etherkit/CC1/documentation/CC1-PCB-AF.png

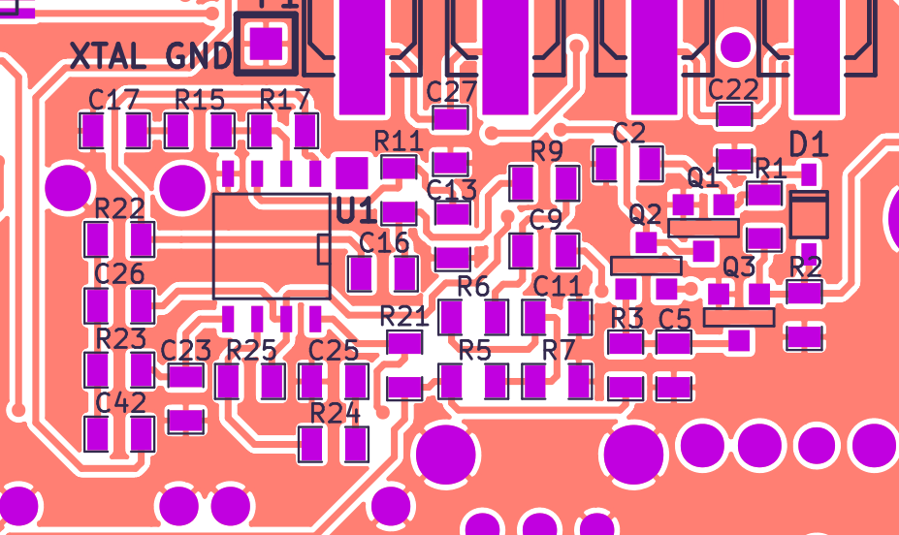
documentation/CC1-PCB-AF.png
