etherkit/CC1/pcb/CC1-PCB-Back.png

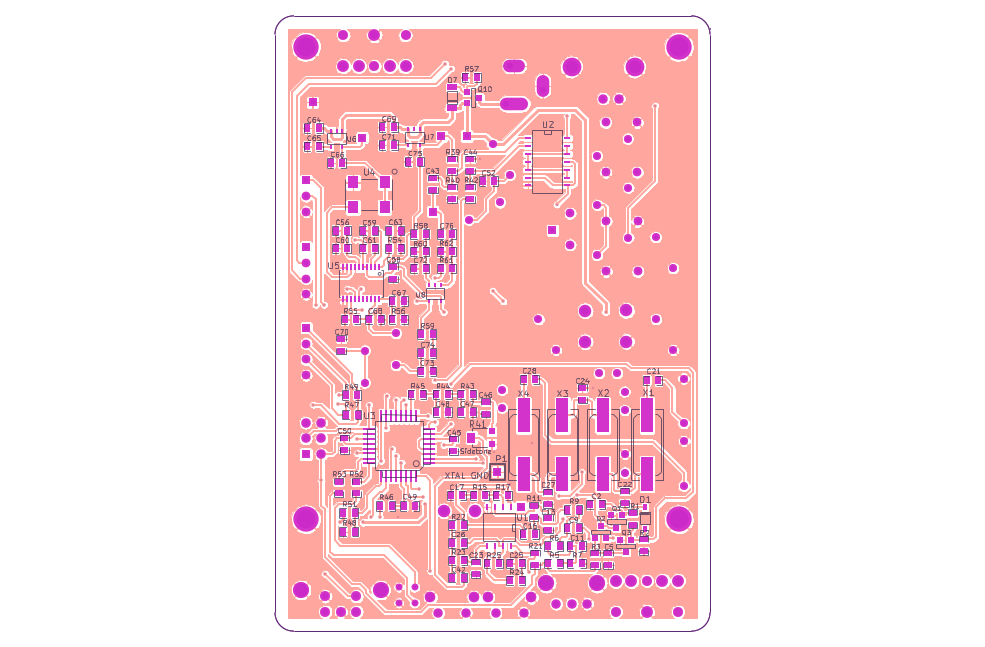
pcb/CC1-PCB-Back.png
