etherkit/CC1/pcb/CC1_PCB_Front.png

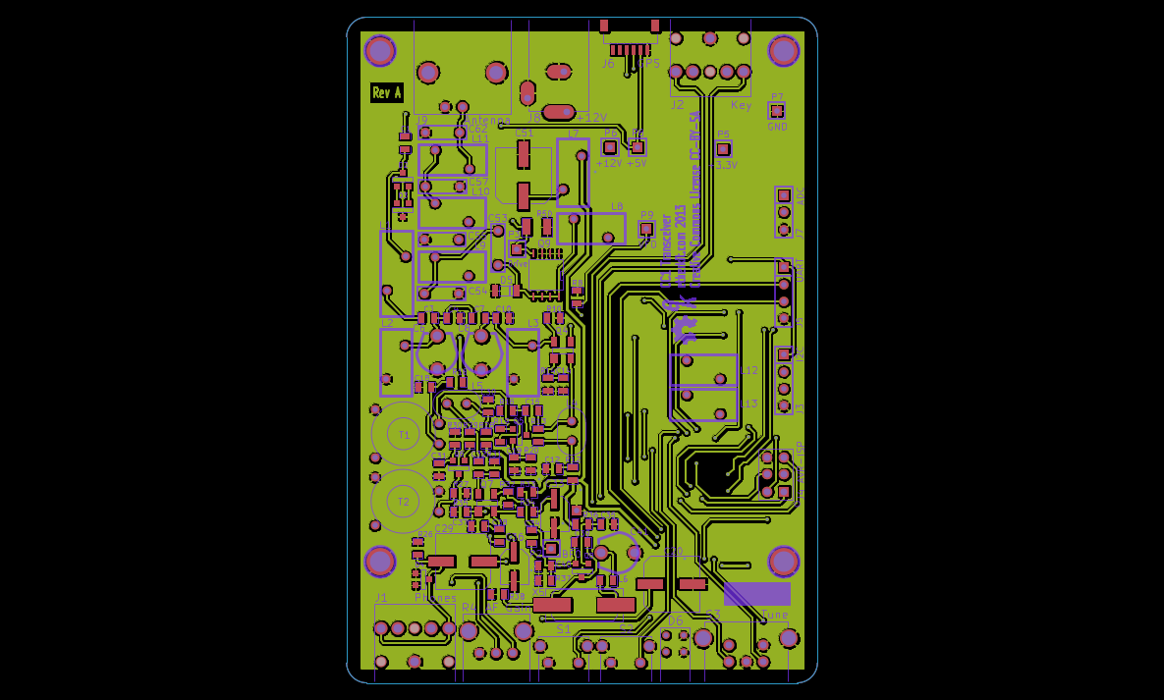
pcb/CC1_PCB_Front.png
