etherkit/CC1/documentation/CC1 Schematics.pdf

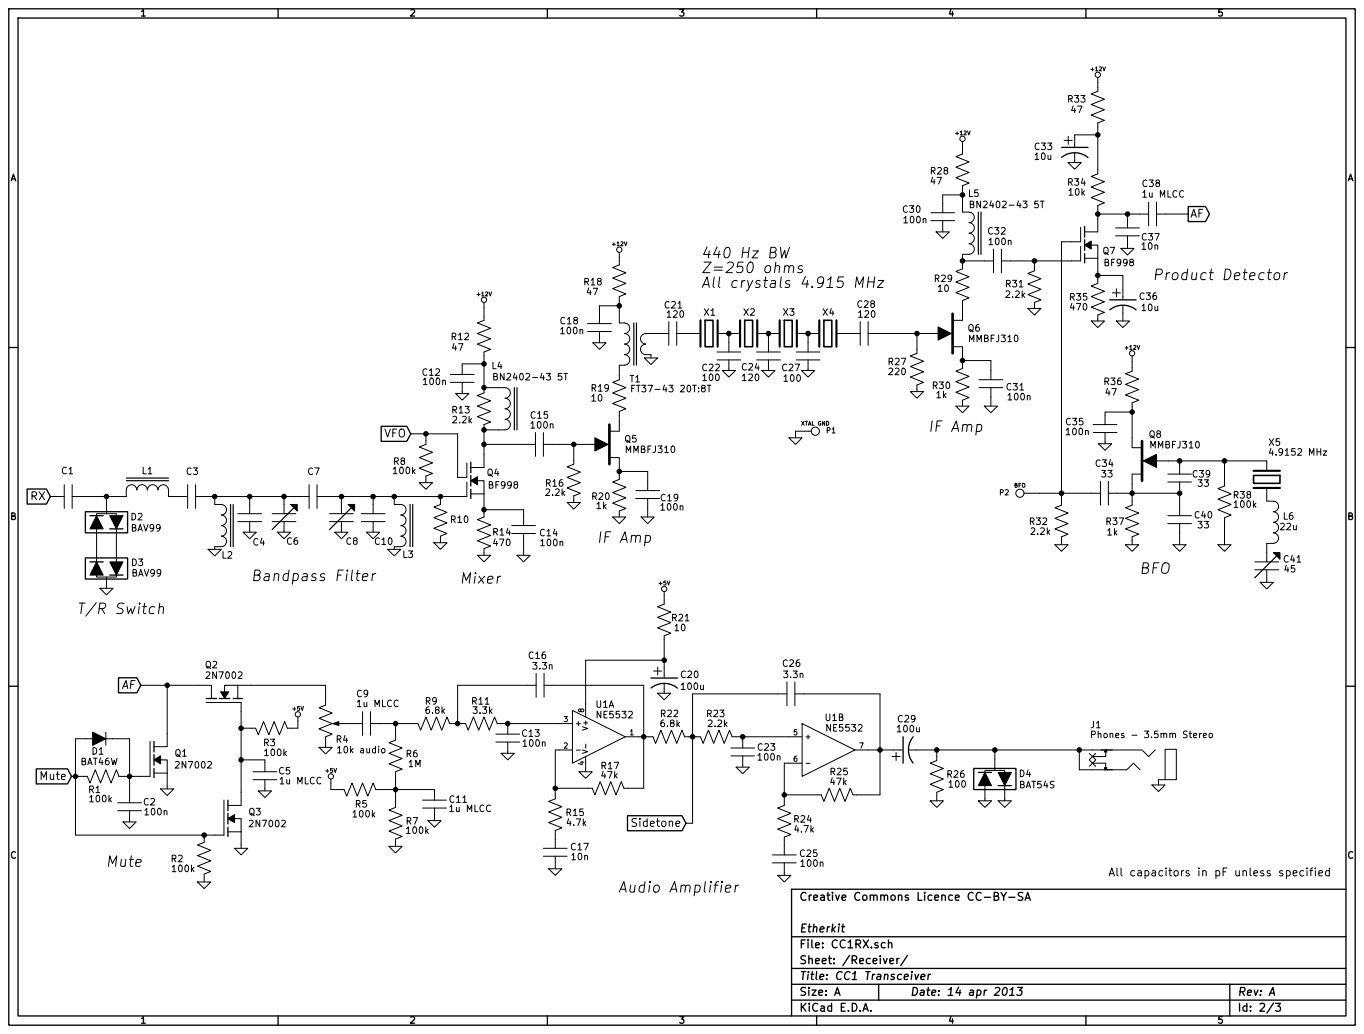
[picture p4: page 1]

Sheet: /Receiver/ Etherkit Creative Commons Licence CC-BY-SA

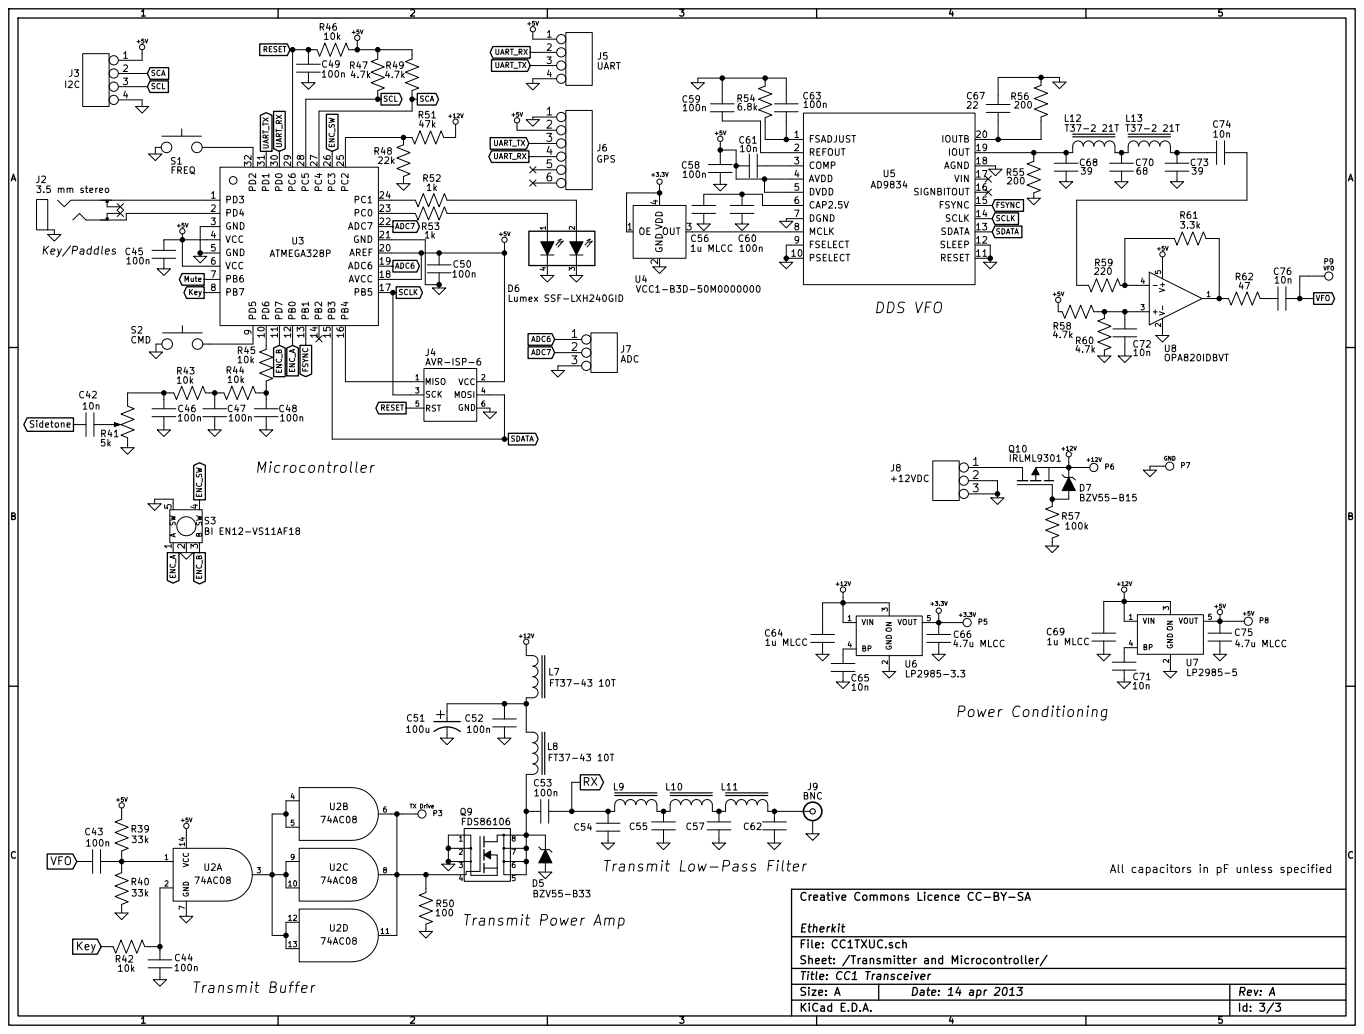
[picture p5: page 2]

3.5 mm stereo Key/Paddles

VCC GND MISO MOSI RST

J9 BNC RX Transmit Power Amp

Transmit Low-Pass Filter

Sheet: /Transmitter and Microcontroller/ Etherkit Creative Commons Licence CC-BY-SA
