etherkit/CC1/pcb/CC1.pdf

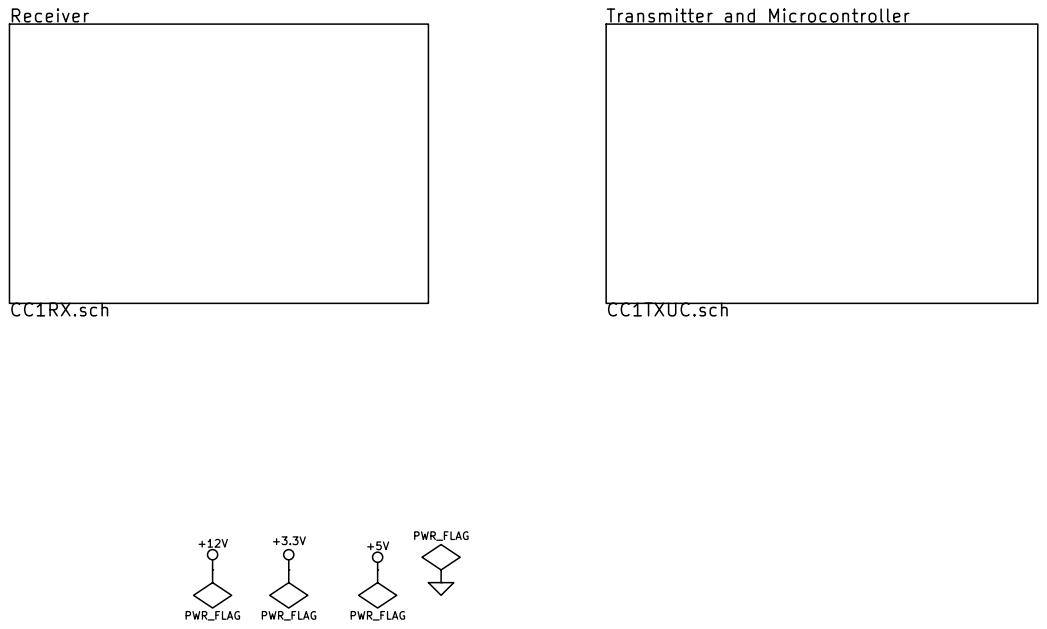
[picture p6: page 1]

Sheet: / Etherkit Creative Commons Licence CC-BY-SA


Sheet: /Receiver/ Etherkit Creative Commons Licence CC-BY-SA


3.5 mm stereo Key/Paddles

VCC GND MISO MOSI RST

J9 BNC RX Transmit Power Amp

Transmit Low-Pass Filter

Sheet: /Transmitter and Microcontroller/ Etherkit Creative Commons Licence CC-BY-SA
