etherkit/CC1/pcb/CC1.kicad_pcb

## KiCad design pcb/CC1.kicad_pcb (2013-01-31)

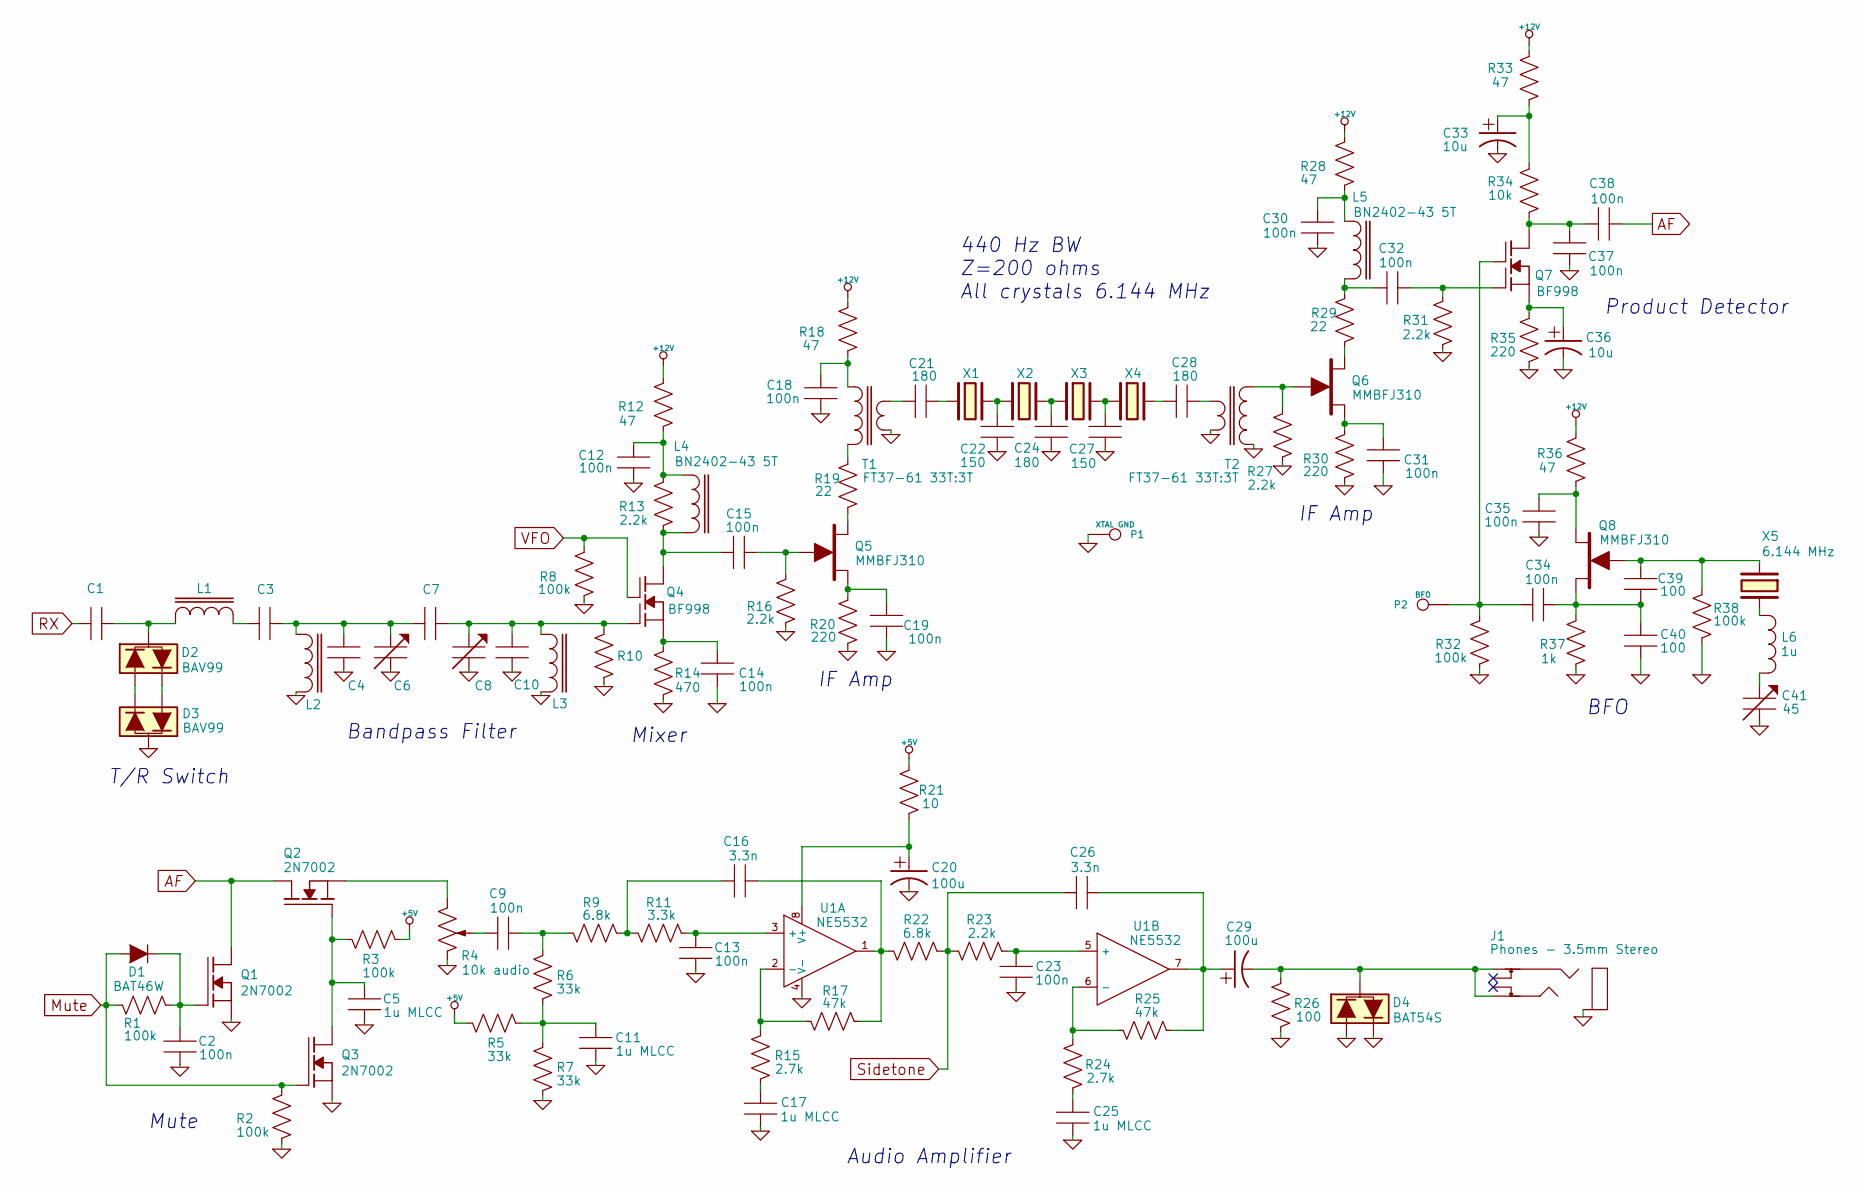
[picture p7: schematic CC1RX.sch, CC1 Transceiver]

Parts:
C1, C3, C4, C7, C10: C
C2, C9, C12, C13, C14, C15, C18, C19, C23, C30, C31, C32, C34, C35, C37, C38: 100n
C5, C11, C17, C25: 1u MLCC
C6, C8: CTRIM
C16, C26: 3.3n
C20, C29: 100u
C21, C24, C28: 180
C22, C27: 150
C33, C36: 10u
C39, C40: 100
C41: 45
D1: BAT46W
D2, D3: BAV99
D4: BAT54S
J1: Phones - 3.5mm Stereo
L1, L2, L3: L-IRONCORE
L4, L5: BN2402-43 5T
L6: 1u
P1: XTAL GND
P2: BFO
Q1, Q2, Q3: 2N7002
Q4, Q7: BF998
Q5, Q6, Q8: MMBFJ310
R1, R2, R3, R8, R32, R38: 100k
R4: 10k audio
R5, R6, R7: 33k
R9, R22: 6.8k
R10: R
R11: 3.3k
R12, R18, R28, R33, R36: 47
R13, R16, R23, R27, R31: 2.2k
R14: 470
R15, R24: 2.7k
R17, R25: 47k
R19, R29: 22
R20, R30, R35: 220
R21: 10
R26: 100
R34: 10k
R37: 1k
T1, T2: FT37-61 33T:3T
U1: NE5532
X1, X2, X3, X4, X5: 6.144 MHz

Connections:
+5V: R3.2, R5.1, R21.1; also elsewhere on the board
+12V: R12.1, R18.1, R28.1, R33.1, R36.1; also elsewhere on the board
AF: C38.1, Q1.3 (D), Q2.3 (D)
GND: C2.2, C4.1, C5.2, C6.2, C8.2, C10.1, C11.2, C12.2, C13.2, C14.1, C17.2, C18.2, C19.1, C20.2, C22.2, C23.2, C24.2, C25.2, C27.2, C30.2, C31.1, C33.2, C35.2, C36.2, C37.2, C40.1, C41.2, D3.3, D4.1, D4.2, J1.1, L2.2, L3.2, P1.1, Q1.1 (S), Q3.1 (S), R2.2, R4.3, R7.2, R8.2, R10.2, R14.2, R16.2, R20.2, R26.2, R27.2, R30.2, R31.2, R32.2, R35.2, R37.2, R38.2, T1.4, T2.2, T2.4, U1.4 (V-); also elsewhere on the board
Mute: D1.1 (A), Q3.2 (G), R1.1, R2.1; also elsewhere on the board
unnamed: C18.1, R18.2, T1.1
unnamed: R19.1, T1.2
unnamed: C15.1, Q5.2 (G), R16.1
unnamed: Q5.3 (D), R19.2
unnamed: C21.2, T1.3
unnamed: C21.1, X1.1
unnamed: C28.2, X4.2
unnamed: C28.1, T2.3
unnamed: C12.1, L4.1, R12.2, R13.1
unnamed: C15.2, L4.2, Q4.2 (D), R13.2
unnamed: C24.1, X2.2, X3.1
unnamed: C19.2, Q5.1 (S), R20.1
unnamed: C30.1, L5.1, R28.2
unnamed: Q6.3 (D), R29.2
unnamed: C33.1, R33.2, R34.1
unnamed: C37.1, C38.2, Q7.2 (D), R34.2
unnamed: C27.1, X3.2, X4.1
unnamed: C22.1, X1.2, X2.1
unnamed: C31.2, Q6.1 (S), R30.1
unnamed: Q6.2 (G), R27.1, T2.1
unnamed: C3.1, L1.2
unnamed: R24.1, R25.1, U1.6 (-)
unnamed: C23.1, R23.2, U1.5 (+)
unnamed: C25.1, R24.2
unnamed: C14.2, Q4.1 (S), R14.1
unnamed: C1.2, D2.3, L1.1
unnamed: D2.1, D3.2
unnamed: D2.2, D3.1
unnamed: C7.2, C8.1, C10.2, L3.1, Q4.4 (G1), R10.1
unnamed: C3.2, C4.2, C6.1, C7.1, L2.1
unnamed: C16.2, R9.2, R11.1
unnamed: C20.1, R21.2, U1.8 (V+)
unnamed: C26.1, C29.1, R25.2, U1.7
unnamed: C13.1, R11.2, U1.3 (+)
unnamed: C16.1, R17.2, R22.1, U1.1
unnamed: C17.1, R15.2
unnamed: R15.1, R17.1, U1.2 (-)
unnamed: C29.2, D4.3, J1.2, J1.5, R26.1
unnamed: C9.1, R6.1, R9.1
unnamed: C39.2, Q8.2 (G), R38.1, X5.1
unnamed: C34.1, C39.1, C40.2, Q8.1 (S), R37.1
unnamed: C35.1, Q8.3 (D), R36.2
unnamed: C32.1, Q7.4 (G1), R31.1
unnamed: C36.1, Q7.1 (S), R35.1
unnamed: C32.2, L5.2, R29.1
unnamed: C34.2, P2.1, Q7.3 (G2), R32.1
unnamed: C41.1, L6.2
unnamed: L6.1, X5.2
unnamed: C5.1, Q2.2 (G), Q3.3 (D), R3.1
unnamed: Q2.1 (S), R4.1
unnamed: C9.2, R4.2
unnamed: C11.1, R5.2, R6.2, R7.1
unnamed: C2.1, D1.2 (K), Q1.2 (G), R1.2
RX: C1.1; also elsewhere on the board
Sidetone: C26.2, R22.2, R23.1; also elsewhere on the board
VFO: Q4.3 (G2), R8.1; also elsewhere on the board

Notes on the sheet:
BFO
440 Hz BW Z=200 ohms All crystals 6.144 MHz
Mute
Product Detector
IF Amp
Mixer
Bandpass Filter
T/R Switch
Audio Amplifier

Schematic: CC1TXUC.sch, CC1 Transceiver

Parts:
C42, C43, C44, C45, C46, C47, C48, C49, C50, C52, C53, C54, C55, C57, C58, C59, C60, C62, C63: 100n
C51: 100u
C56, C64, C69: 1u MLCC
C61, C65, C71, C72, C74, C76: 10n
C66, C75: 4.7u MLCC
C67: 22
C68, C73: 39
C70: 68
D5, D7: BZV55-B15
D6: Lumex SSF-LXH240GID
J2: 3.5 mm stereo
J3: I2C
J4: AVR-ISP-6
J5: UART
J6: GPS
J7: ADC
J8: +12VDC
J9: BNC
L7, L8: FT37-43 10T
L9, L10, L11: L-IRONCORE
L12, L13: T37-2 21T
P3: TX Drive
P5: +3.3V
P6: +12V
P7: GND
P8: +5V
P9: VFO
Q9: FDS86106
Q10: IRLML9301
R39, R40, R43, R44, R45: 33k
R41: 5k
R42, R46: 10k
R47, R49, R58, R60: 4.7k
R48: 22k
R50: 100
R51: 47k
R52, R53: 1k
R54: 6.8k
R55, R56: 200
R57: 100k
R59: 220
R61: 2.2k
R62: 51
S1: FREQ
S2: CMD
S3: BI EN12-VS11AF18
U2: 74AC08
U3: ATMEGA328P; MODULE
U4: VCC1-B3D-50M0000000
U5: AD9834
U6: LP2985-3.3
U7: LP2985-5
U8: OPA820IDBVT

Connections:
+3.3V: C66.2, P5.1, U4.1 (OE), U4.4 (VDD), U6.5 (VOUT)
+5V: C45.2, C50.2, C58.2, C61.1, C75.2, J3.1, J4.2, J5.1, J6.2, P8.1, R39.1, R46.1, R47.1, R49.1, R58.2, U2.14 (VCC), U3.4, U3.6, U3.18, U3.20, U5.4 (AVDD), U5.5 (DVDD), U7.5 (VOUT), U8.5 (V+); also elsewhere on the board
+12V: C64.2, C69.2, D7.2 (K), L7.1, P6.1, Q10.1 (S), R51.1, U6.1 (VIN), U6.3 (ON), U7.1 (VIN), U7.3 (ON); also elsewhere on the board
ADC6: J7.1, U3.19
ADC7: J7.2 (PM), U3.22
ENC_A: S3.1 (A), U3.12
ENC_B: S3.3 (B), U3.11
ENC_SW: S3.4 (SW), U3.26
FSYNC: U3.13, U5.15 (FSYNC)
GND: C44.1, C45.1, C46.1, C47.1, C48.1, C49.1, C50.1, C51.2, C52.1, C54.1, C55.1, C56.1, C57.1, C58.1, C59.2, C60.1, C62.1, C63.2, C64.1, C65.1, C66.1, C67.2, C68.1, C69.1, C70.1, C71.1, C72.1, C73.1, C75.1, D5.1 (A), D6.3 (K), D6.4 (K), J2.1, J3.4, J4.6, J5.4, J6.1, J7.3, J8.2 (PM), J8.3, J9.2 (Ext), P7.1, Q9.1 (S), Q9.2 (S), Q9.3 (S), R40.2, R41.3, R48.2, R50.2, R54.1, R55.2, R56.1, R57.2, R60.2, R62.2, S1.1, S2.1, S3.2, S3.5 (SW), U2.7 (GND), U3.3, U3.5, U3.21, U4.2 (GND), U5.7 (DGND), U5.9 (FSELECT), U5.10 (PSELECT), U5.11 (RESET), U5.12 (SLEEP), U5.18 (AGND), U6.2 (GND), U7.2 (GND), U8.2 (V-); also elsewhere on the board
Key: R42.2, U3.8
Mute: U3.7; also elsewhere on the board
unnamed: C61.2, U5.3 (COMP)
unnamed: C63.1, R54.2, U5.1 (FSADJUST)
unnamed: C56.2, C60.2, U5.6 (CAP2.5V)
unnamed: C59.1, U5.2 (REFOUT)
unnamed: C67.1, R56.2, U5.20 (IOUTB)
unnamed: C68.2, L12.1, R55.1, U5.19 (IOUT)
unnamed: C70.2, L12.2, L13.1
unnamed: C73.2, C74.1, L13.2
unnamed: U4.3 (OUT), U5.8 (MCLK)
unnamed: C71.2, U7.4 (BP)
unnamed: C65.2, U6.4 (BP)
unnamed: D7.1 (A), Q10.2 (G), R57.1
unnamed: C44.2, R42.1, U2.2
unnamed: C72.2, R58.1, R60.1, U8.3 (+)
unnamed: R59.1, R61.2, U8.4 (-)
unnamed: C74.2, R59.2
unnamed: J8.1, Q10.3 (D)
unnamed: C76.1, R61.1, R62.1, U8.1
unnamed: C51.1, C52.2, L7.2, L8.1
unnamed: C53.1, D5.2 (K), L8.2, Q9.5 (D), Q9.6 (D), Q9.7 (D), Q9.8 (D)
unnamed: C62.2, J9.1 (In), L11.2
unnamed: C57.2, L10.2, L11.1
unnamed: C55.2, L9.2, L10.1
unnamed: J2.5, U3.1
unnamed: J2.2, U3.2
unnamed: C43.2, R39.2, R40.1, U2.1
unnamed: U2.3, U2.4, U2.5, U2.9, U2.10, U2.12, U2.13
unnamed: P3.1, Q9.4 (G), R50.1, U2.6, U2.8, U2.11
unnamed: D6.2 (A), R52.1
unnamed: R52.2, U3.24
unnamed: D6.1 (A), R53.1
unnamed: R53.2, U3.23
unnamed: R48.1, R51.2, U3.25
unnamed: S2.2, U3.9
unnamed: S1.2, U3.32
unnamed: R45.1, U3.10
unnamed: C48.2, R44.1, R45.2
unnamed: C47.2, R43.1, R44.2
unnamed: C46.2, R41.1, R43.2
unnamed: J4.1, U3.16
unnamed: C42.2, R41.2
RESET: C49.2, J4.5, R46.2, U3.29
RX: C53.2, C54.2, L9.1; also elsewhere on the board
SCA: J3.2, R49.2, U3.27
SCL: J3.3, R47.2, U3.28
SCLK: J4.3, U3.17, U5.14 (SCLK)
SDATA: J4.4, U3.15, U5.13 (SDATA)
Sidetone: C42.1; also elsewhere on the board
UART_RX: J5.2, J6.4, U3.30
UART_TX: J5.3, J6.3, U3.31
VFO: C43.1, C76.2, P9.1; also elsewhere on the board

Notes on the sheet:
Transmit Buffer
Transmit Power Amp
Transmit Low-Pass Filter
Key/Paddles
Microcontroller
DDS VFO
Power Conditioning

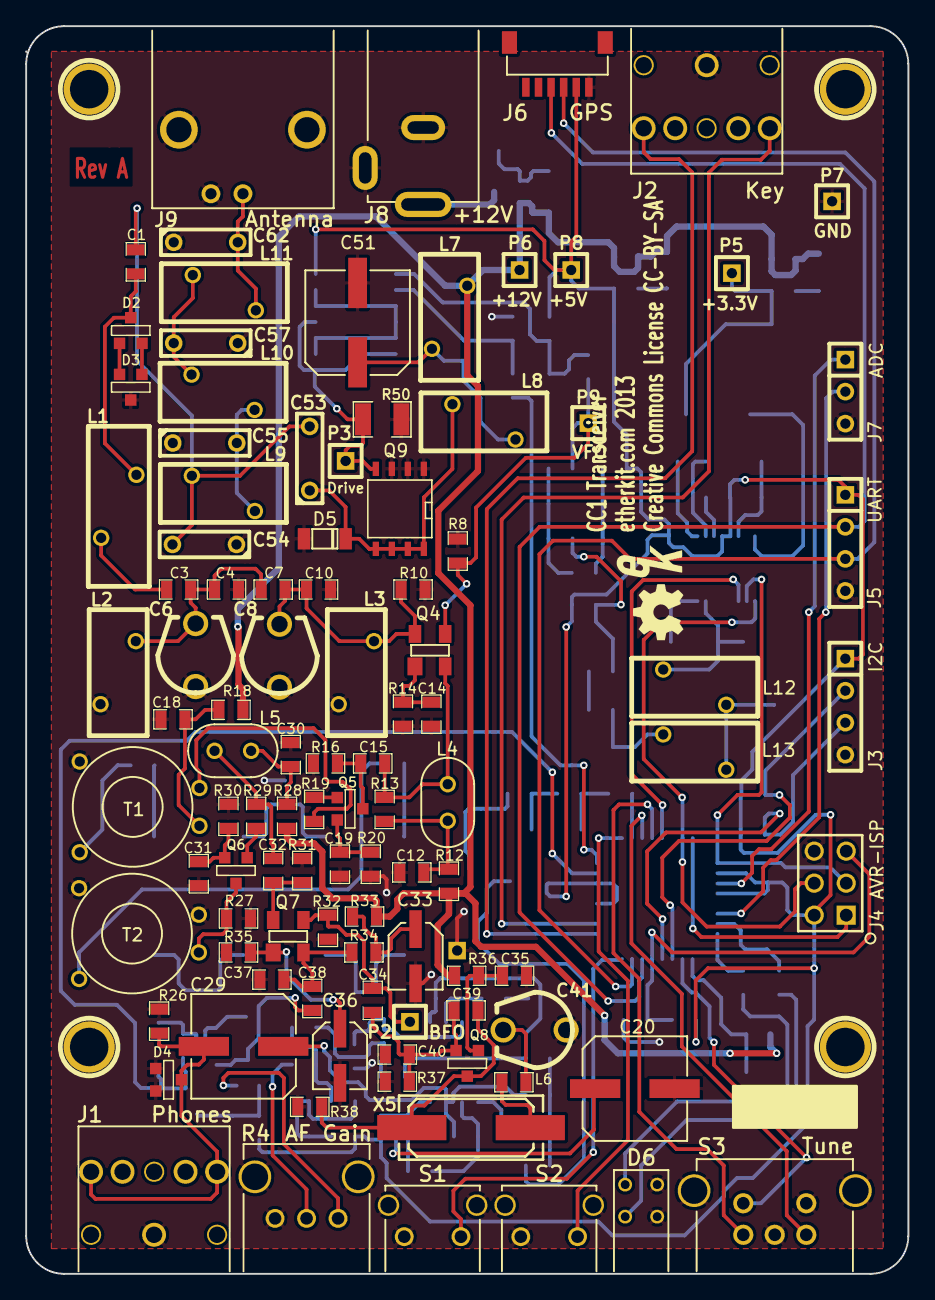
[picture p8: board CC1.kicad_pcb from above]

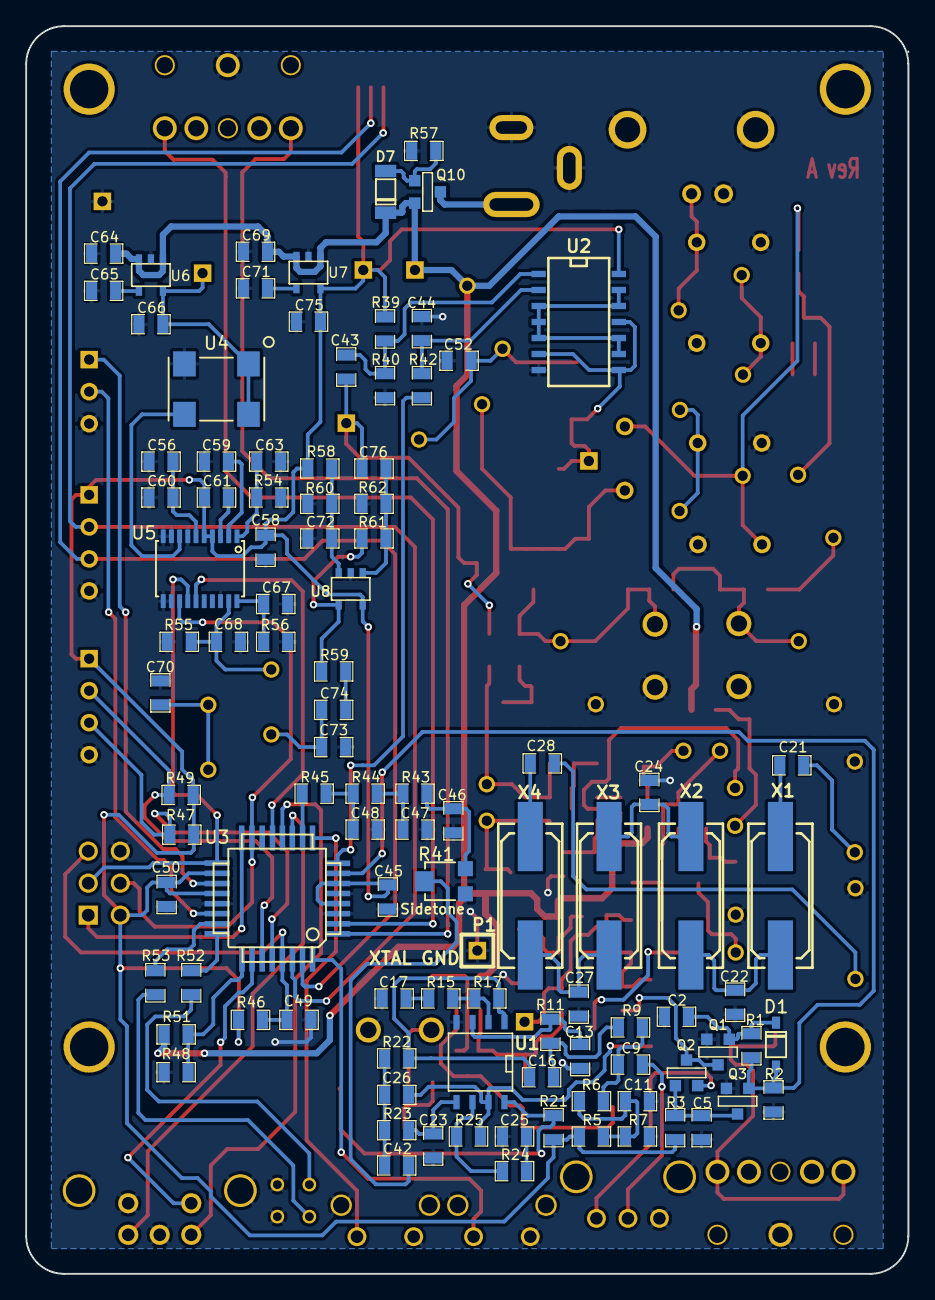
[picture p9: board CC1.kicad_pcb from below]

Board: 2 copper layers, 70.0 x 99.0 mm, 208 parts (101 on the bottom side), 117 nets.

Other parts of the board:
1PIN, 1PIN#2, 1PIN#3, 1PIN#4: P***; MOUNTINGHOLE
Ref**: Val**; EtherkitLogoSmall

Their connections:
GND: 1PIN.1, 1PIN#2.1, 1PIN#3.1, 1PIN#4.1; also elsewhere on the board
