etherkit/CC1/firmware/sinewave.h

/*
 * sinewave.h
 *
 *  Created on: Dec 14, 2010
 *      Author: jason
 */

#ifndef SINEWAVE_H_
#define SINEWAVE_H_

#include <stdint.h>
#include <avr/pgmspace.h>

#define PWM_ARRAY_SIZE			256

const uint8_t sinewave[] PROGMEM =
	{
	0x80,0x83,0x86,0x89,0x8c,0x8f,0x92,0x95,0x98,0x9c,0x9f,0xa2,0xa5,0xa8,0xab,0xae,
	0xb0,0xb3,0xb6,0xb9,0xbc,0xbf,0xc1,0xc4,0xc7,0xc9,0xcc,0xce,0xd1,0xd3,0xd5,0xd8,
	0xda,0xdc,0xde,0xe0,0xe2,0xe4,0xe6,0xe8,0xea,0xec,0xed,0xef,0xf0,0xf2,0xf3,0xf5,
	0xf6,0xf7,0xf8,0xf9,0xfa,0xfb,0xfc,0xfc,0xfd,0xfe,0xfe,0xff,0xff,0xff,0xff,0xff,
	0xff,0xff,0xff,0xff,0xff,0xff,0xfe,0xfe,0xfd,0xfc,0xfc,0xfb,0xfa,0xf9,0xf8,0xf7,
	0xf6,0xf5,0xf3,0xf2,0xf0,0xef,0xed,0xec,0xea,0xe8,0xe6,0xe4,0xe2,0xe0,0xde,0xdc,
	0xda,0xd8,0xd5,0xd3,0xd1,0xce,0xcc,0xc9,0xc7,0xc4,0xc1,0xbf,0xbc,0xb9,0xb6,0xb3,
	0xb0,0xae,0xab,0xa8,0xa5,0xa2,0x9f,0x9c,0x98,0x95,0x92,0x8f,0x8c,0x89,0x86,0x83,
	0x80,0x7c,0x79,0x76,0x73,0x70,0x6d,0x6a,0x67,0x63,0x60,0x5d,0x5a,0x57,0x54,0x51,
	0x4f,0x4c,0x49,0x46,0x43,0x40,0x3e,0x3b,0x38,0x36,0x33,0x31,0x2e,0x2c,0x2a,0x27,
	0x25,0x23,0x21,0x1f,0x1d,0x1b,0x19,0x17,0x15,0x13,0x12,0x10,0x0f,0x0d,0x0c,0x0a,
	0x09,0x08,0x07,0x06,0x05,0x04,0x03,0x03,0x02,0x01,0x01,0x00,0x00,0x00,0x00,0x00,
	0x00,0x00,0x00,0x00,0x00,0x00,0x01,0x01,0x02,0x03,0x03,0x04,0x05,0x06,0x07,0x08,
	0x09,0x0a,0x0c,0x0d,0x0f,0x10,0x12,0x13,0x15,0x17,0x19,0x1b,0x1d,0x1f,0x21,0x23,
	0x25,0x27,0x2a,0x2c,0x2e,0x31,0x33,0x36,0x38,0x3b,0x3e,0x40,0x43,0x46,0x49,0x4c,
	0x4f,0x51,0x54,0x57,0x5a,0x5d,0x60,0x63,0x67,0x6a,0x6d,0x70,0x73,0x76,0x79,0x7c
	};

/*
const uint8_t sinewave[] PROGMEM =
	{
	127,130,133,136,139,143,146,149,152,155,158,161,164,167,170,173,176,178,181,184,187,190,192,195,198,200,203,205,208,210,212,215,217,219,221,223,225,227,229,231,233,234,236,238,239,240,
	242,243,244,245,247,248,249,249,250,251,252,252,253,253,253,254,254,254,254,254,254,254,253,253,253,252,252,251,250,249,249,248,247,245,244,243,242,240,239,238,236,234,233,231,229,227,225,223,
	221,219,217,215,212,210,208,205,203,200,198,195,192,190,187,184,181,178,176,173,170,167,164,161,158,155,152,149,146,143,139,136,133,130,127,124,121,118,115,111,108,105,102,99,96,93,90,87,84,81,78,
	76,73,70,67,64,62,59,56,54,51,49,46,44,42,39,37,35,33,31,29,27,25,23,21,20,18,16,15,14,12,11,10,9,7,6,5,5,4,3,2,2,1,1,1,0,0,0,0,0,0,0,1,1,1,2,2,3,4,5,5,6,7,9,10,11,12,14,15,16,18,20,21,23,25,27,29,31,
	33,35,37,39,42,44,46,49,51,54,56,59,62,64,67,70,73,76,78,81,84,87,90,93,96,99,102,105,108,111,115,118,121,124

	};
	*/
/*
const uint8_t sinewave[] PROGMEM =
	{
	0x80,0x8c,0x98,0xa5,0xb0,0xbc,0xc7,0xd1,
	0xda,0xe2,0xea,0xf0,0xf6,0xfa,0xfd,0xff,
	0xff,0xff,0xfd,0xfa,0xf6,0xf0,0xea,0xe2,
	0xda,0xd1,0xc7,0xbc,0xb0,0xa5,0x98,0x8c,
	0x80,0x73,0x67,0x5a,0x4f,0x43,0x38,0x2e,
	0x25,0x1d,0x15,0x0f,0x09,0x05,0x02,0x00,
	0x00,0x00,0x02,0x05,0x09,0x0f,0x15,0x1d,
	0x25,0x2e,0x38,0x43,0x4f,0x5a,0x67,0x73
	};
	*/

/*
const uint8_t sinewave[] PROGMEM =
	{
	0x00,
	0x25,
	0x80,
	0xda,
	0xff,
	0xda,
	0x80,
	0x25
	};
	*/

/*
const uint8_t sinewave[] PROGMEM =
	{
	0x00,0x09,
	0x25,0x4f,
	0x80,0xb0,
	0xda,0xf6,
	0xff,0xf6,
	0xda,0xb0,
	0x80,0x4f,
	0x25,0x09
	};
*/

/*
const uint8_t sinewave[] PROGMEM =
	{
	0x80,0x98,0xb0,0xc7,
	0xda,0xea,0xf6,0xfd,
	0xff,0xfd,0xf6,0xea,
	0xda,0xc7,0xb0,0x98,
	0x80,0x67,0x4f,0x38,
	0x25,0x15,0x09,0x02,
	0x00,0x02,0x09,0x15,
	0x25,0x38,0x4f,0x67
	};
	*/

#endif /* SINEWAVE_H_ */
