etherkit/CC1/(commit log)

2013-01-31 First commit, conversion to CC1
    [CC1-B_Cu.gbl, CC1-B_Mask.gbs, CC1-B_SilkS.gbo, CC1-Edge_Cuts.gbr, CC1-F_Cu.gtl, CC1-F_Mask.gts, CC1-F_SilkS.gto, CC1-NPTH.drl]
2013-01-31 Update schematics for beta
    [CC1.sch, CC1RX.sch, CC1TXUC.sch]
2013-02-24 Beta test 1
    [CC1.sch, CC1RX.sch, CC1TXUC.sch]
2013-02-25 Minor correction for Beta 1
    [CC1.sch, CC1RX.sch, CC1TXUC.sch]
2013-02-25 A few more changes on Beta 1
    [CC1.sch, CC1RX.sch, CC1TXUC.sch]
2013-03-20 Minor typo correction on BOM
    [main.c]
2013-04-07 Firmware fix for RX osc hash
    [main.c]
2013-04-14 Change to T1 and L5 in schematics/BOM
    [CC1.sch, CC1RX.sch, CC1TXUC.sch]
