etherkit/CC1/(notices)

Notices in the files:
pcb/CC1.kicad_pcb:
Creative Commons License CC-BY-SA
